Makerfabs/Home-Assistant-Camera-OV3660/README.md

# Makerfabs Home Assistant Camera OV3660

## Intruduce

[Product Link](https://www.makerfabs.com/ov3660-3m-camera-for-home-assistant.html)

[Wiki Link]()
