Makerfabs/Home-Assistant-Camera-OV3660/hardware/OV3660 3M Camera for Home Assistant V1.1.PDF

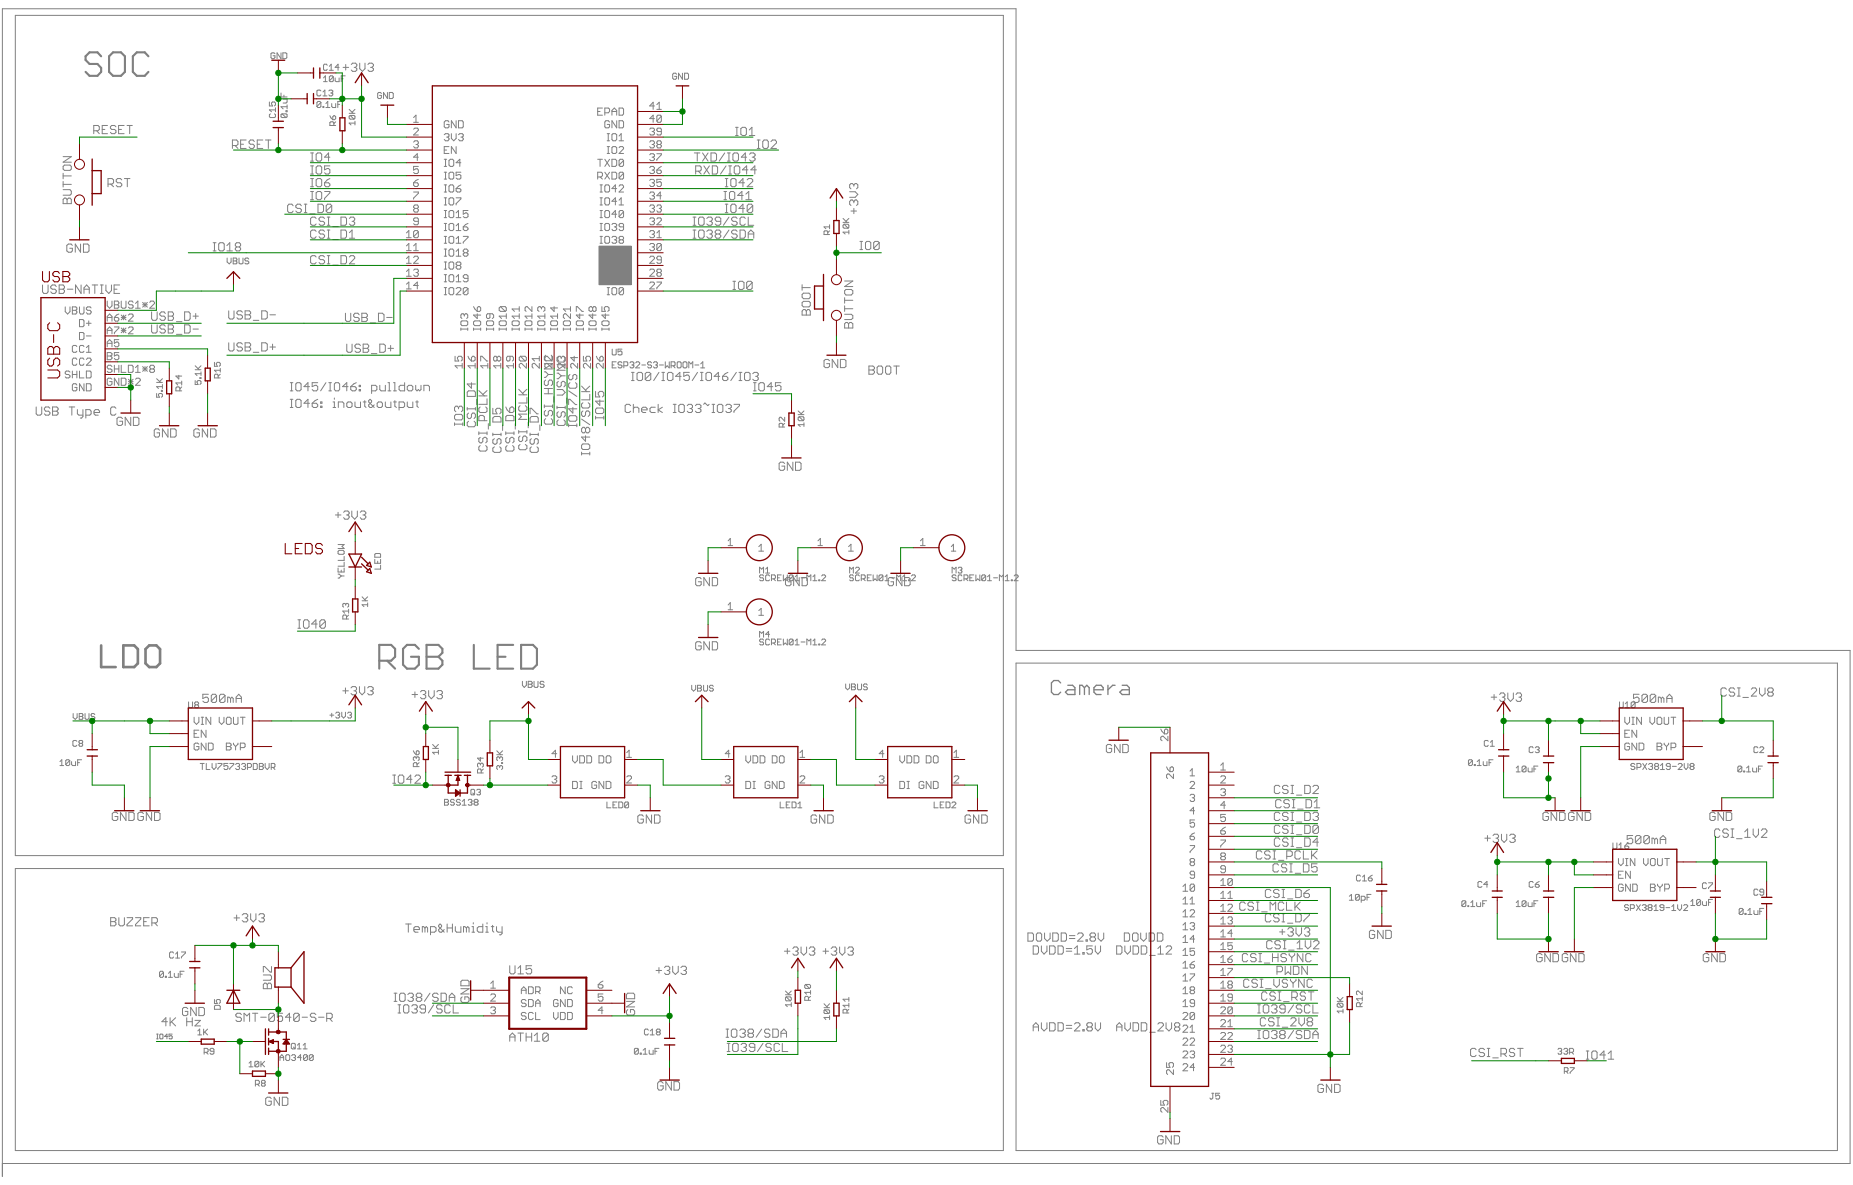
[picture p1: page 1]
