Makerfabs/Home-Assistant-Camera-OV3660/hardware/OV3660 3M Camera for Home Assistant V1.1.brd

## EAGLE design hardware/OV3660 3M Camera for Home Assistant V1.1.brd (2026-01-19)

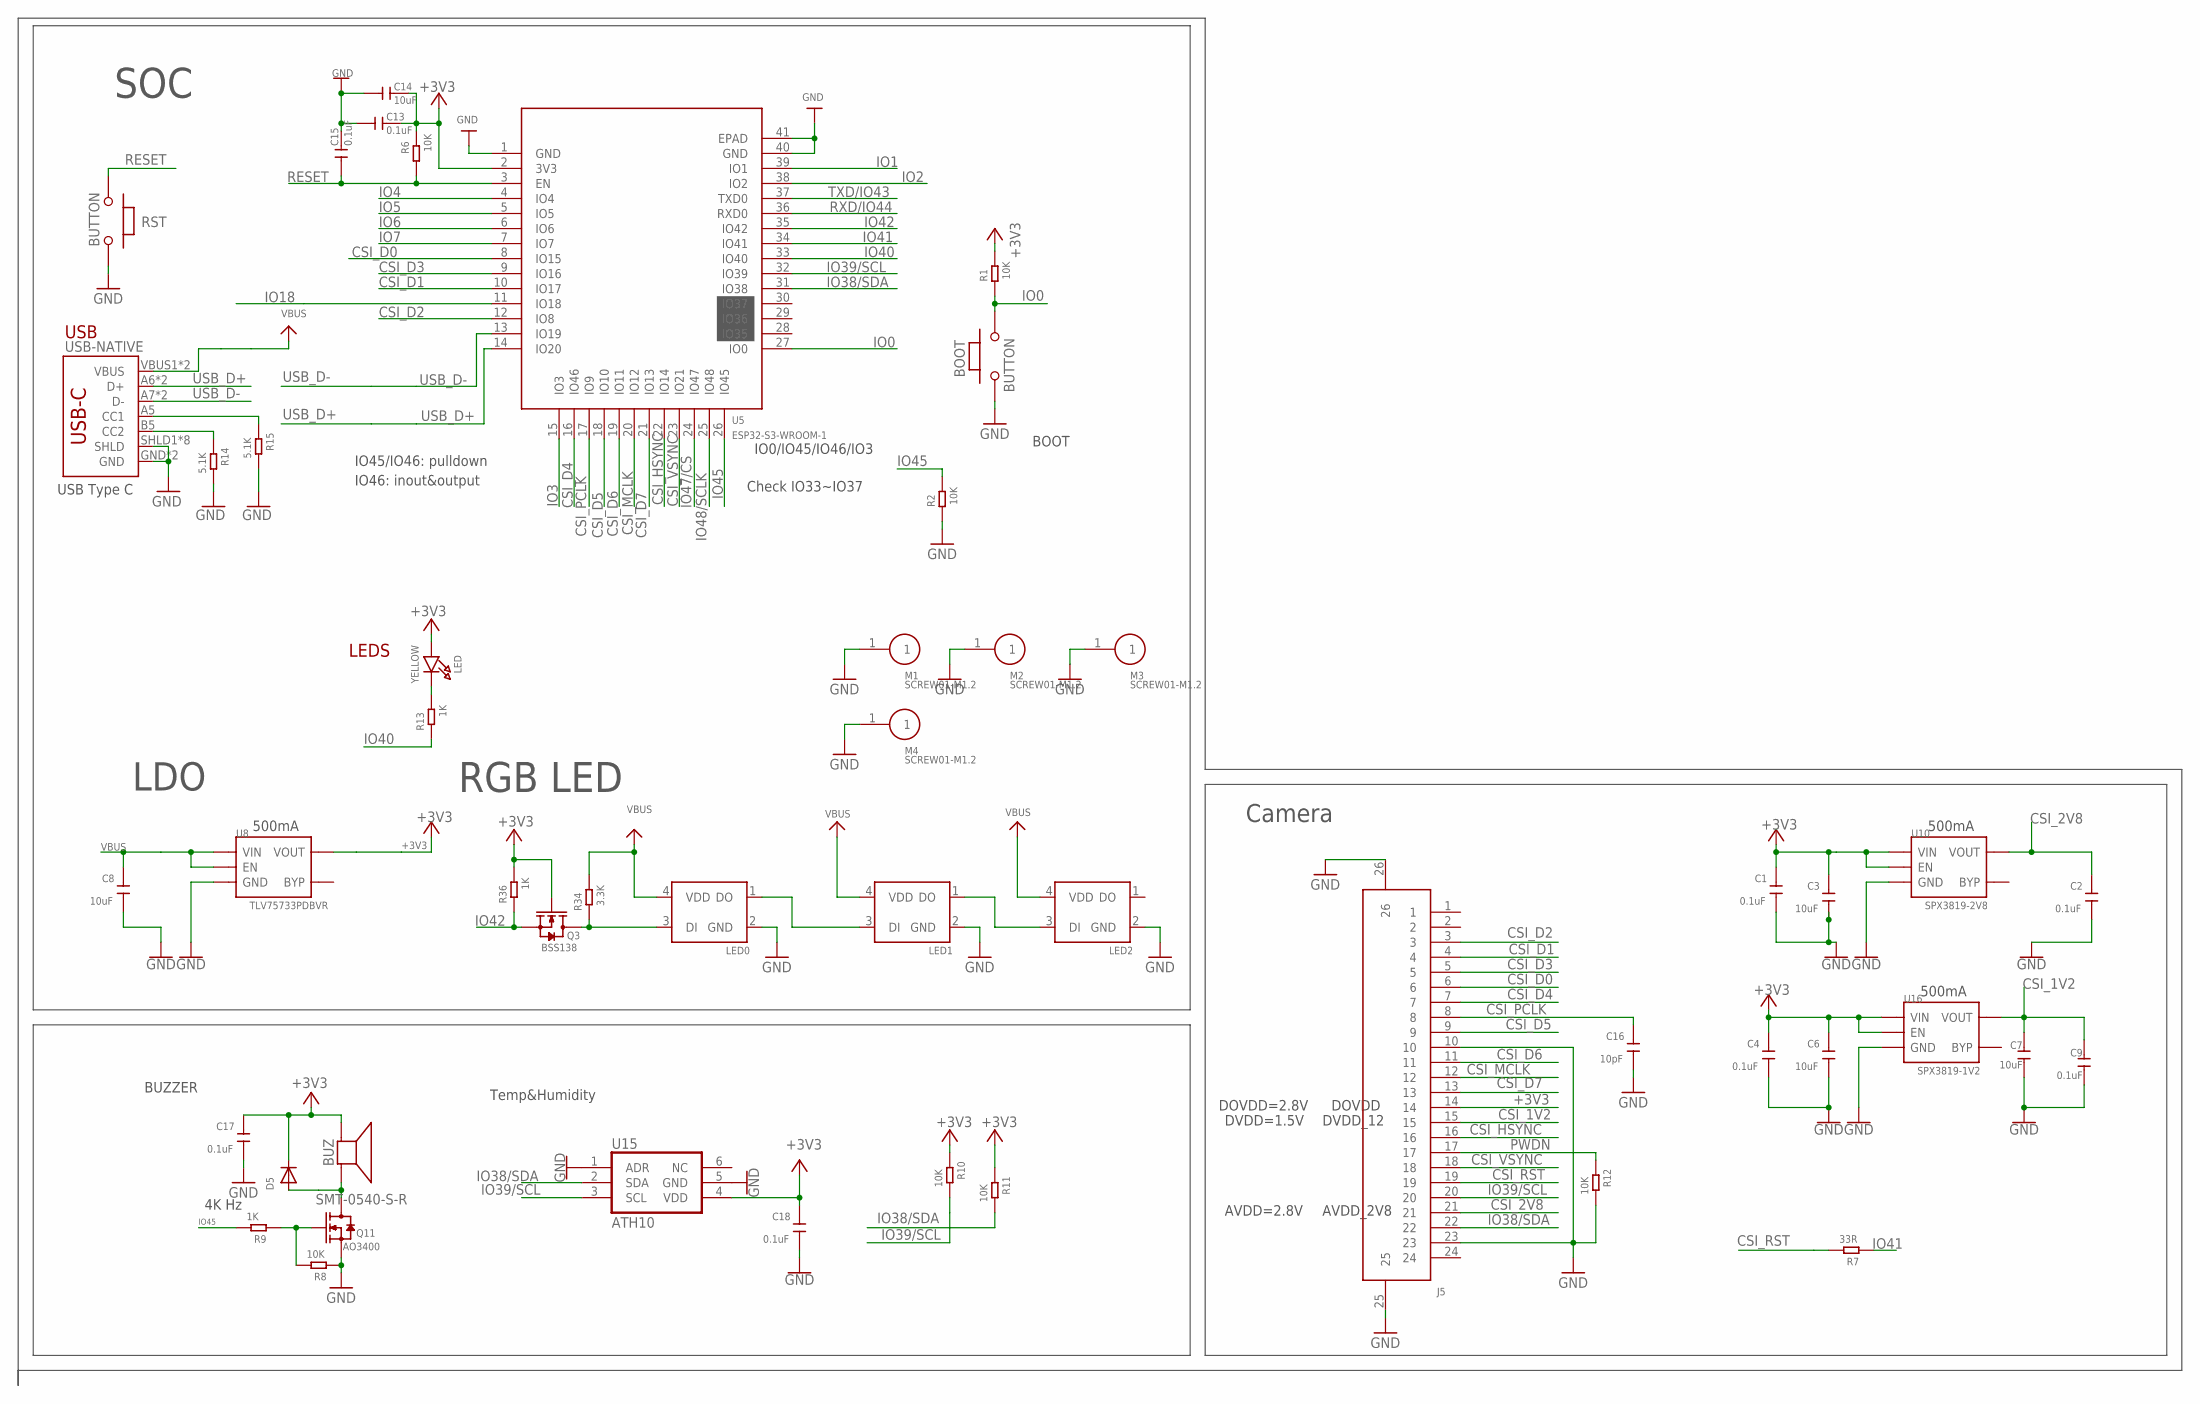
[picture p2: schematic OV3660 3M Camera for Home Assistant V1.1.sch]

Parts:
BOOT: BUTTON; 157SW
BUZ: SMT-0540-S-R
C1, C2, C4, C9, C13, C15, C17, C18: 0.1uF; DISCRETE_C0402
C3, C6, C7, C8, C14: 10uF; DISCRETE_C0402
C16: 10pF; DISCRETE_C0402
D5: DIODESOD-323F; SOD-323F
J5: FPC-24P; SMD26-50P-1760L450W
LED: YELLOW; CHIPLED_0805_NOOUTLINE
LED0, LED1, LED2: WS2812B-2020
M1, M2, M3, M4: SCREW01-M1.2; THD1-M1.2
Q3: BSS138; SOT23@1
Q11: AO3400; SOT23@1
R1, R2, R6, R8, R10, R11, R12: 10K; DISCRETE_R0402
R7: 33R; DISCRETE_R0402
R9, R13, R36: 1K; DISCRETE_R0402
R14, R15: 5.1K; DISCRETE_R0402
R34: 3.3K; DISCRETE_R0402
RST: BUTTON; 157SW
U5: ESP32-S3-WROOM-1
U8: TLV75733PDBVR; SOT23-5
U10: SPX3819-2V8; SOT23-5
U15: ATH10; AHT10
U16: SPX3819-1V2; SOT23-5
USB-NATIVE: USB_C5; USB-C-16P-5

Connections:
+3V3: BUZ.+ (-), C1.2, C3.2, C4.2, C6.2, C13.1, C14.1, C17.2, C18.2, D5.C, J5.14, LED.A, Q3.1 (G), R1.2, R6.2, R10.1, R11.1, R36.2, U5.2 (3V3), U8.5 (VOUT), U10.1 (VIN), U10.3 (EN), U15.4 (VDD), U16.1 (VIN), U16.3 (EN)
CSI_1V2: C7.2, C9.2, J5.15, U16.5 (VOUT)
CSI_2V8: C2.2, J5.21, U10.5 (VOUT)
CSI_D0: J5.6, U5.8 (IO15)
CSI_D1: J5.4, U5.10 (IO17)
CSI_D2: J5.3, U5.12 (IO8)
CSI_D3: J5.5, U5.9 (IO16)
CSI_D4: J5.7, U5.16 (IO46)
CSI_D5: J5.9, U5.18 (IO10)
CSI_D6: J5.11, U5.19 (IO11)
CSI_D7: J5.13, U5.21 (IO13)
CSI_HSYNC: J5.16, U5.22 (IO14)
CSI_MCLK: J5.12, U5.20 (IO12)
CSI_PCLK: C16.2, J5.8, U5.17 (IO9)
CSI_RST: J5.19, R7.2
CSI_VSYNC: J5.18, U5.23 (IO21)
GND: BOOT.1, C1.1, C2.1, C3.1, C4.1, C6.1, C7.1, C8.1, C9.1, C13.2, C14.2, C15.1, C16.1, C17.1, C18.1, J5.10, J5.23, J5.25, J5.26, LED0.2 (GND), LED1.2 (GND), LED2.2 (GND), M1.1, M2.1, M3.1, M4.1, Q11.2 (S), R2.1, R8.1, R12.2, R14.2, R15.2, RST.1, U5.1 (GND), U5.40 (GND), U5.41 (EPAD), U8.2 (GND), U10.2 (GND), U15.1 (ADR), U15.5 (GND), U16.2 (GND), USB-NATIVE.GND, USB-NATIVE.GND2 (GND), USB-NATIVE.SHLD1 (SHLD), USB-NATIVE.SHLD2 (SHLD), USB-NATIVE.SHLD3 (SHLD), USB-NATIVE.SHLD4 (SHLD), USB-NATIVE.SHLD5 (SHLD), USB-NATIVE.SHLD6 (SHLD), USB-NATIVE.SHLD7 (SHLD), USB-NATIVE.SHLD8 (SHLD)
IO0: BOOT.2, R1.1, U5.27 (IO0)
IO1: U5.39 (IO1)
IO2: U5.38 (IO2)
IO3: U5.15 (IO3)
IO4: U5.4 (IO4)
IO5: U5.5 (IO5)
IO6: U5.6 (IO6)
IO7: U5.7 (IO7)
IO18: U5.11 (IO18)
IO38/SDA: J5.22, R11.2, U5.31 (IO38), U15.2 (SDA)
IO39/SCL: J5.20, R10.2, U5.32 (IO39), U15.3 (SCL)
IO40: R13.1, U5.33 (IO40)
IO41: R7.1, U5.34 (IO41)
IO42: Q3.2 (S), R36.1, U5.35 (IO42)
IO45: R2.2, R9.2, U5.26 (IO45)
IO47/CS: U5.24 (IO47)
IO48/SCLK: U5.25 (IO48)
M-1: BUZ.- (+), D5.A, Q11.3 (D)
unnamed: LED1.1 (DO), LED2.3 (DI)
unnamed: LED0.1 (DO), LED1.3 (DI)
unnamed: LED.C, R13.2
unnamed: LED0.3 (DI), Q3.3 (D), R34.1
unnamed: Q11.1 (G), R8.2, R9.1
unnamed: R15.1, USB-NATIVE.A5 (CC1)
unnamed: R14.1, USB-NATIVE.B5 (CC2)
PWDN: J5.17, R12.1
RESET: C15.2, R6.1, RST.2, U5.3 (EN)
RXD/IO44: U5.36 (RXD0)
TXD/IO43: U5.37 (TXD0)
USB_D+: U5.14 (IO20), USB-NATIVE.A6 (D+), USB-NATIVE.B6 (D+)
USB_D-: U5.13 (IO19), USB-NATIVE.A7 (D-), USB-NATIVE.B7 (D-)
VBUS: C8.2, LED0.4 (VDD), LED1.4 (VDD), LED2.4 (VDD), R34.2, U8.1 (VIN), U8.3 (EN), USB-NATIVE.VBUS1 (VBUS), USB-NATIVE.VBUS2 (VBUS)

Notes on the sheet:
500mA
LDO
LEDS
BOOT
IO45/IO46: pulldown
IO46: inout&output
USB
USB Type C
IO0/IO45/IO46/IO3
Check IO33~IO37
SOC
DVDD=1.5V
AVDD=2.8V
DOVDD=2.8V
Camera
AVDD_2V8
DVDD_12
DOVDD
BUZZER
4K Hz
Temp&Humidity
RGB LED

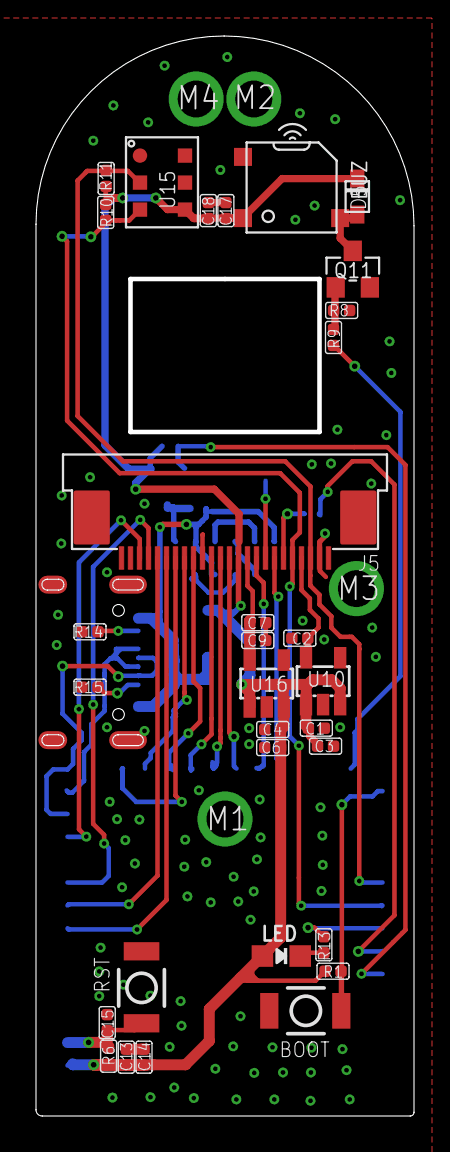
[picture p3: board OV3660 3M Camera for Home Assistant V1.1.brd from above]

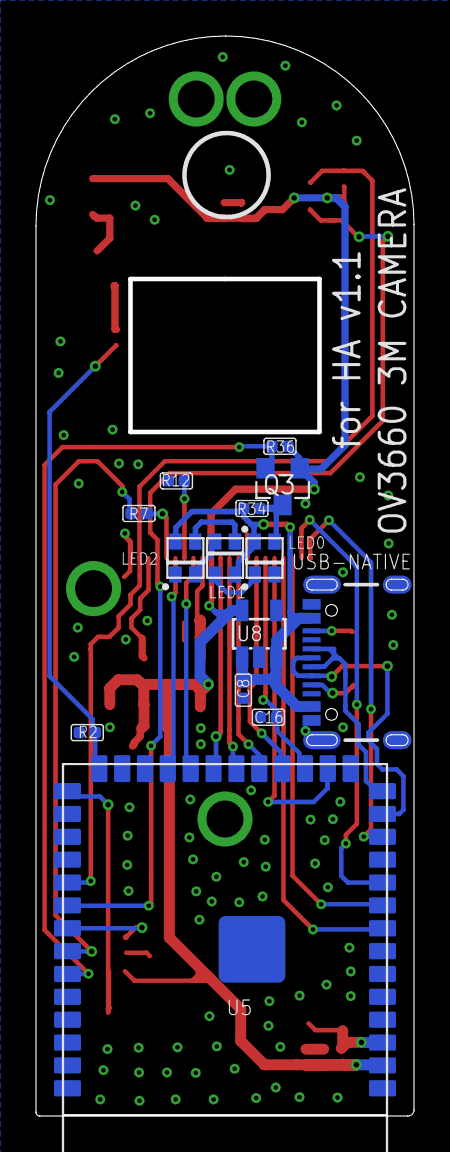
[picture p4: board OV3660 3M Camera for Home Assistant V1.1.brd from below]

Board: 2 copper layers, 21.0 x 60.0 mm, 49 parts (14 on the bottom side), 37 nets.
