Makerfabs/Home-Assistant-Camera-OV3660/(commit log)

2026-01-03 add camera ov3660
    [OV3660 3M Camera for Home Assistant V1.0.brd, OV3660 3M Camera for Home Assistant V1.0.sch]
2026-01-19 fix yaml&delete gerber.rar
2026-01-19 update hardware
    [OV3660 3M Camera for Home Assistant V1.1.brd, OV3660 3M Camera for Home Assistant V1.1.sch]
